Szalacinski/linuxcnc_novaturn_retrofit/README.md

# A LinuxCNC retrofit for the Denford Novaturn
See [here](https://github.com/Szalacinski/mini-rectifier) for the small rectifier boards for the Gecko drivers.
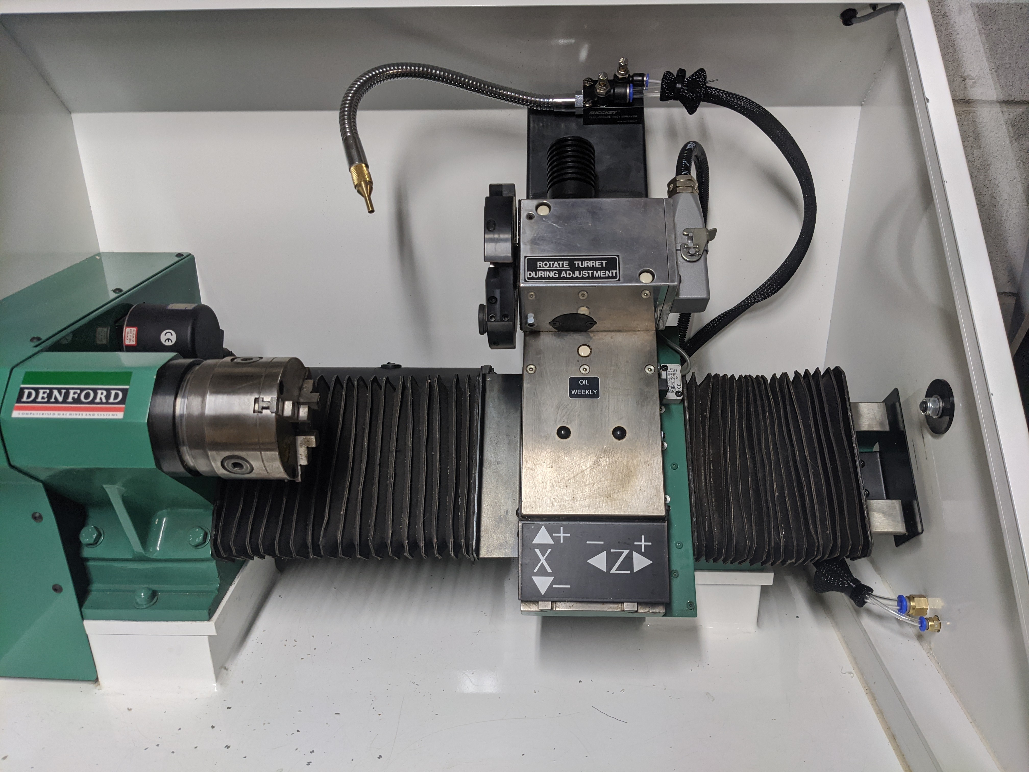
[picture p1: img/01.jpg]
Denford Novaturn CNC lathe
