Szalacinski/linuxcnc_novaturn_retrofit/schematics/mesa_7I85s.sch

## KiCad design schematics/mesa_7I85s.sch (2022-07-25)

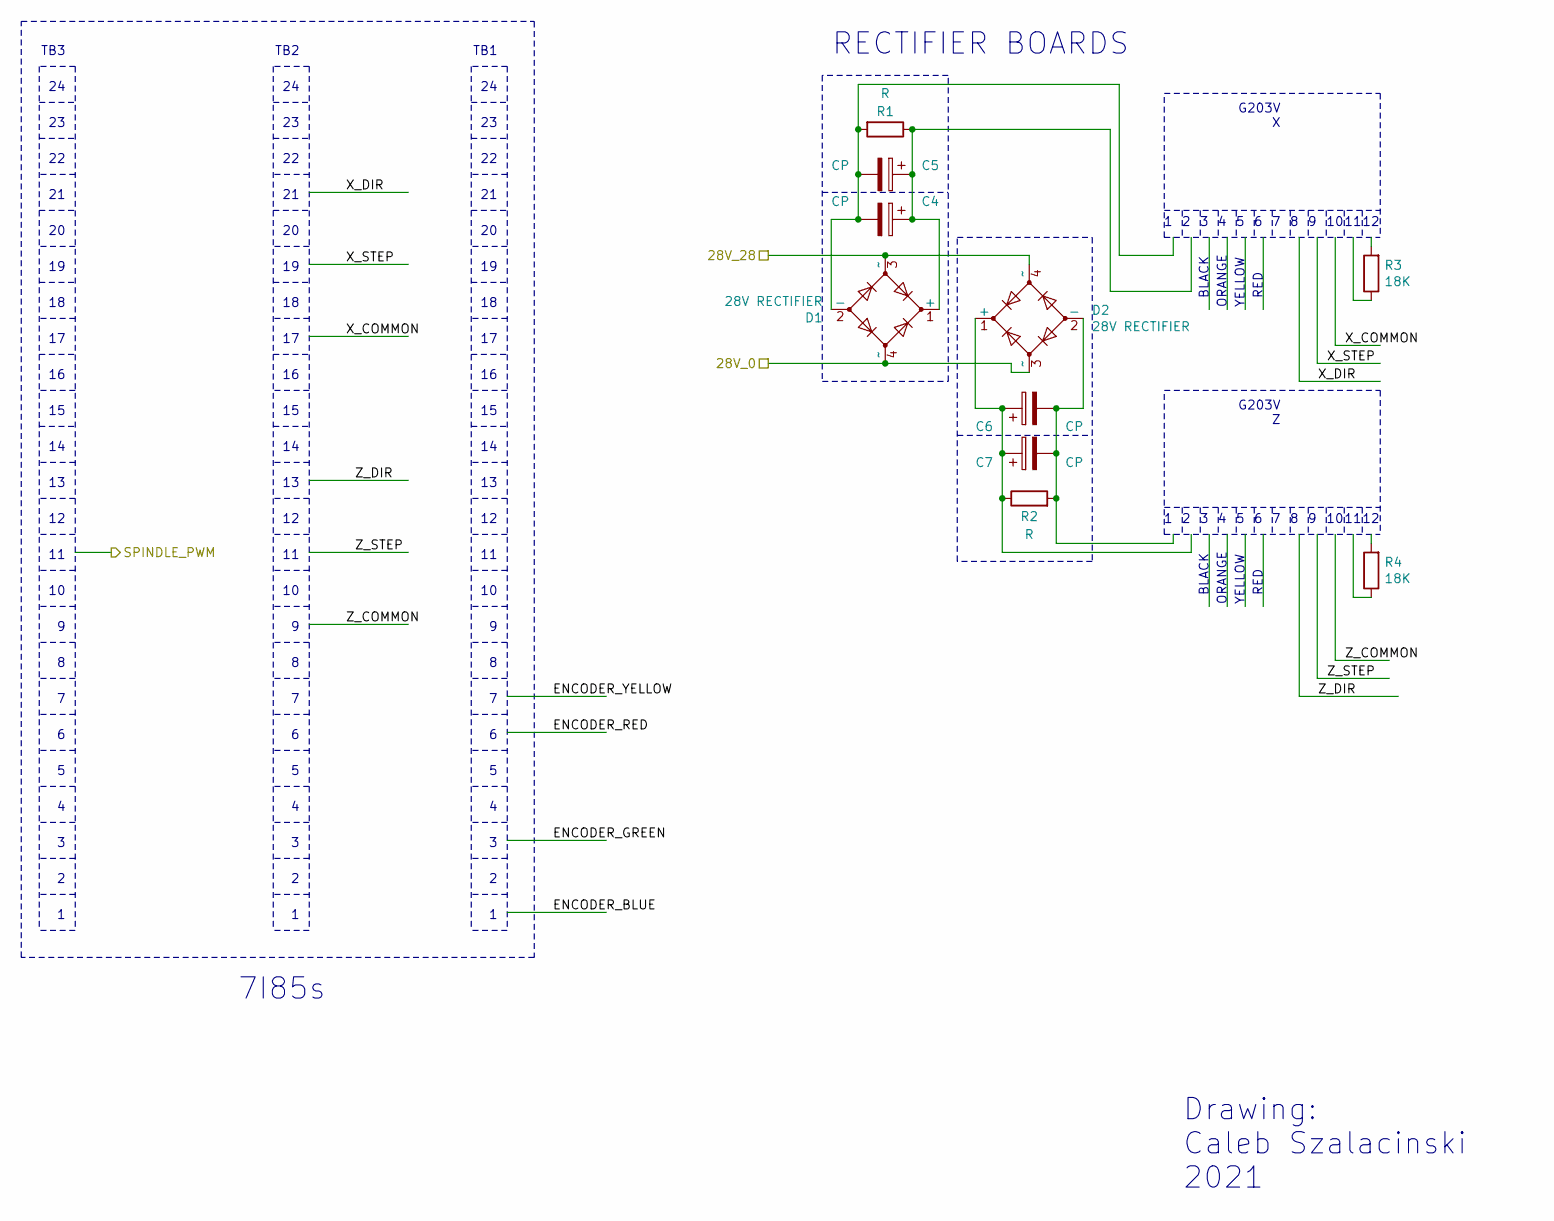
[picture p2: schematic mesa_7I85s.sch]

Parts:
C4, C5, C6, C7: CP
D1, D2: 28V RECTIFIER
R1, R2: R
R3, R4: 18K

Connections:
28V_0: D1.4 (~~), D2.3 (~~)
28V_28: D1.3 (~~), D2.4 (~~)
unnamed: C4.1, C5.1, D1.1 (+), R1.1
unnamed: C4.2, C5.2, D1.2 (-), R1.2
unnamed: C6.1, C7.1, D2.1 (+), R2.1
unnamed: C6.2, C7.2, D2.2 (-), R2.2

Notes on the sheet:
TB1
TB2
TB3
G203V X
G203V Z
RECTIFIER BOARDS
7I85s
BLACK
ORANGE
YELLOW
RED
Drawing: Caleb Szalacinski 2021
