Szalacinski/linuxcnc_novaturn_retrofit/schematics/novaturn.sch

## KiCad design schematics/novaturn.sch (2022-07-25)

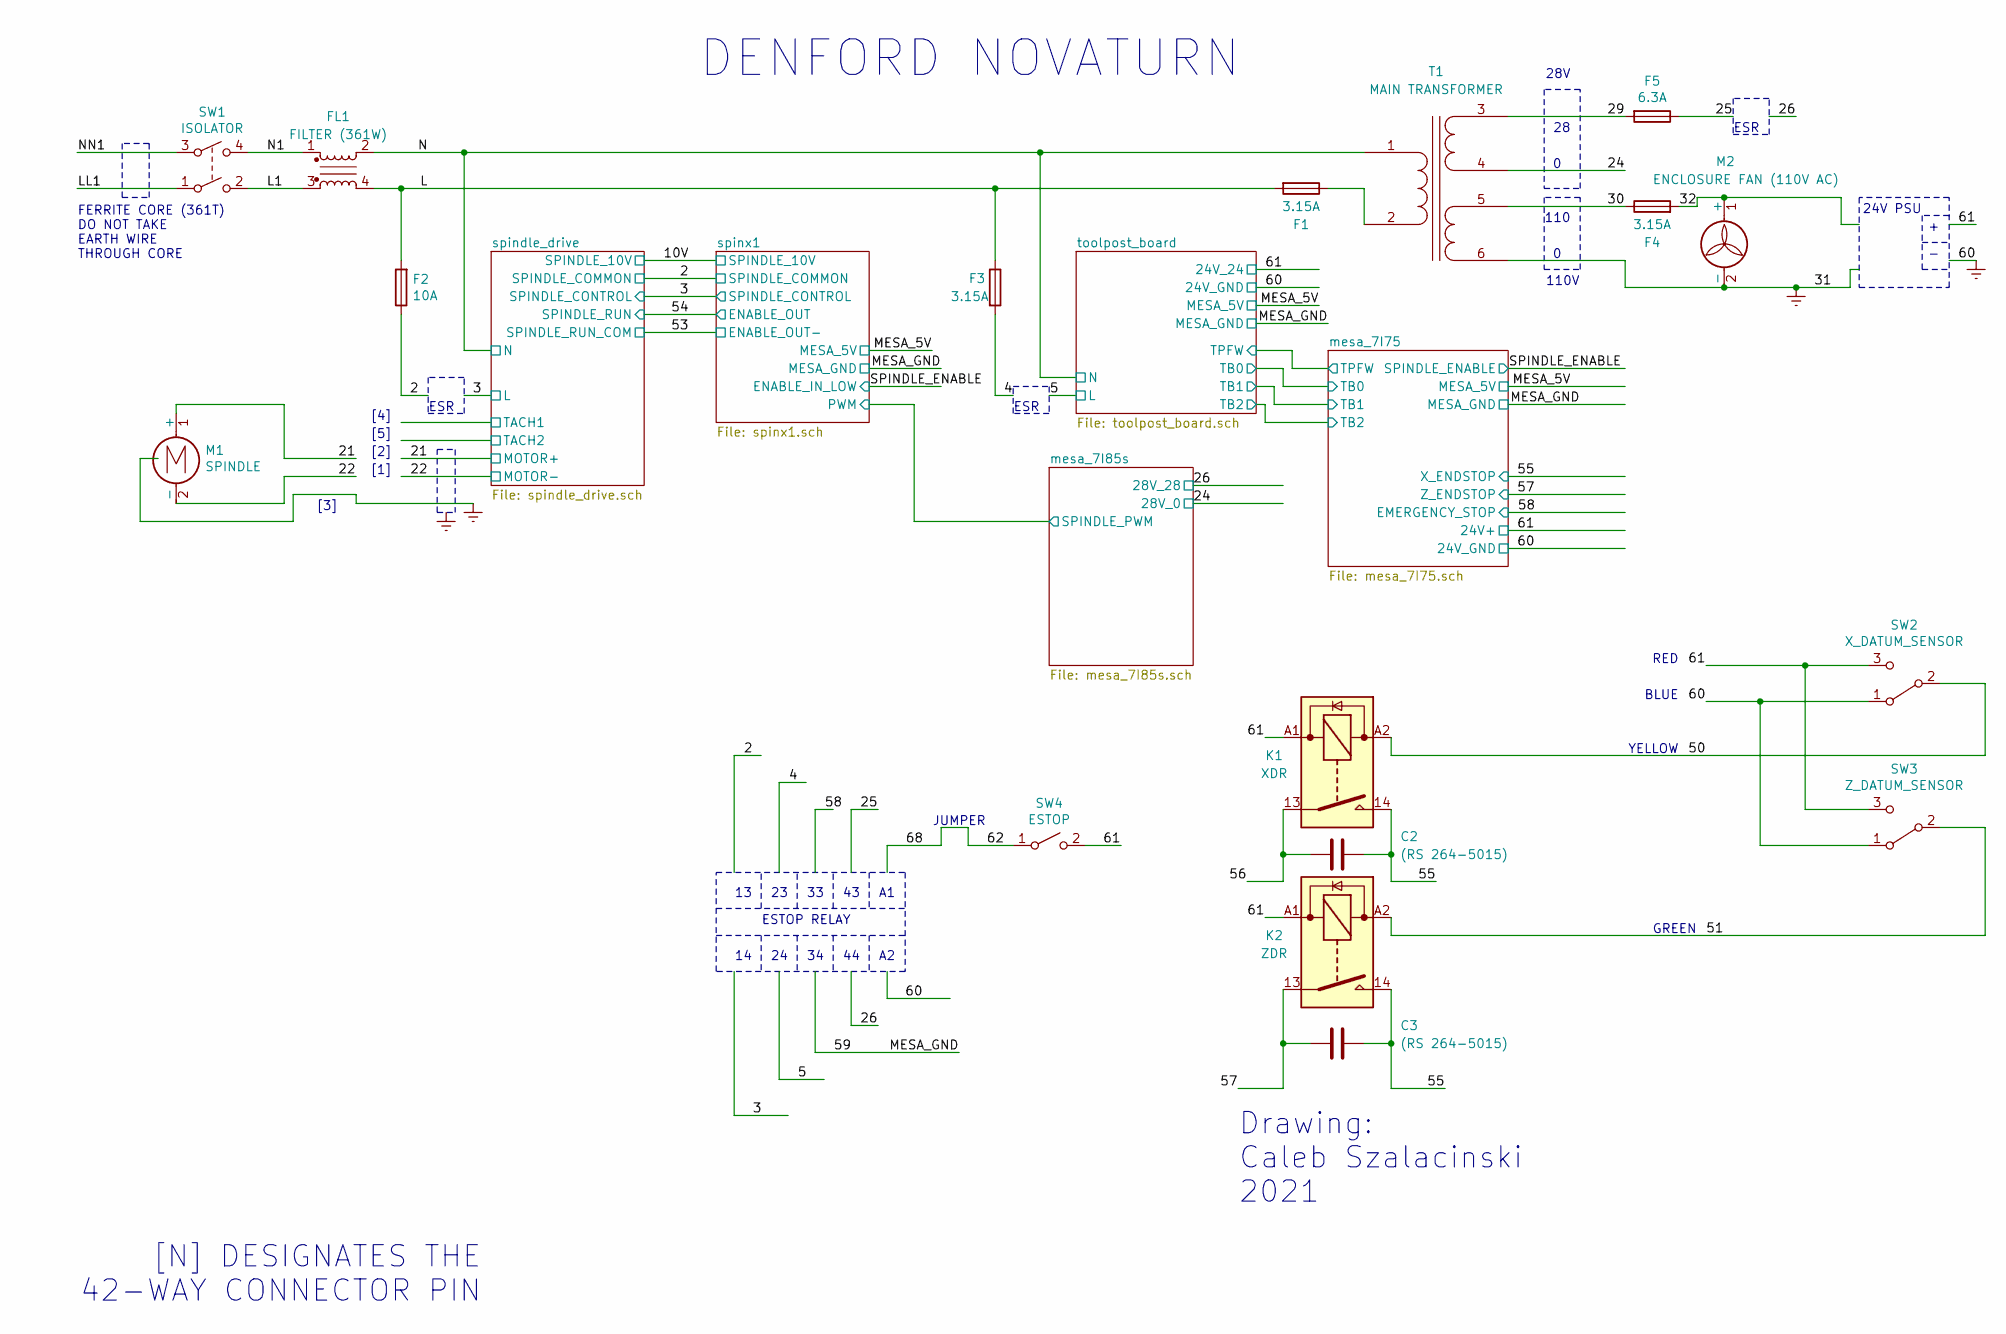
[picture p3: schematic novaturn.sch]

Parts:
C2, C3: (RS 264-5015)
F1, F3, F4: 3.15A
F2: 10A
F5: 6.3A
FL1: FILTER (361W)
K1: XDR; Relay_StandexMeder_DIP_LowProfile
K2: ZDR; Relay_StandexMeder_DIP_LowProfile
M1: SPINDLE
M2: ENCLOSURE FAN (110V AC)
SW1: ISOLATOR
SW2: X_DATUM_SENSOR
SW3: Z_DATUM_SENSOR
SW4: ESTOP
T1: MAIN TRANSFORMER

Connections:
2: F2.1
4: F3.2
21: M1.1 (+)
22: M1.2 (-)
24: T1.4 (SB)
25: F5.1
29: F5.2, T1.3 (SA)
30: F4.1, T1.5 (SC)
32: F4.2, M2.1 (+)
50: K1.A2, SW2.2 (B)
51: K2.A2, SW3.2 (B)
55: C2.1, C3.1, K1.8, K1.14, K2.8, K2.14
56: C2.2, K1.13, K1.14
57: C3.2, K2.13, K2.14
61: K1.13, K1.A1, K2.13, K2.A1, SW2.3 (C), SW3.3 (C), SW4.2 (B)
62: SW4.1 (A)
Earth: M2.2 (-), SW2.1 (A), SW3.1 (A), T1.6 (SD)
L: F1.2, F2.2, F3.1, FL1.4
L1: FL1.3, SW1.2
LL1: SW1.1
N: FL1.2, T1.1 (AA)
N1: FL1.1, SW1.4
NN1: SW1.3
unnamed: F1.1, T1.2 (AB)

Notes on the sheet:
DENFORD NOVATURN
FERRITE CORE (361T) DO NOT TAKE EARTH WIRE THROUGH CORE
[4]
[5]
[2]
[1]
[3]
ESR
[N] DESIGNATES THE 42-WAY CONNECTOR PIN
28V
110V
110
24V PSU
ESR
YELLOW
BLUE
RED
GREEN
Drawing: Caleb Szalacinski 2021
ESTOP RELAY
JUMPER
