Szalacinski/linuxcnc_novaturn_retrofit/schematics/spindle_drive.sch

## KiCad design schematics/spindle_drive.sch (2022-07-25)

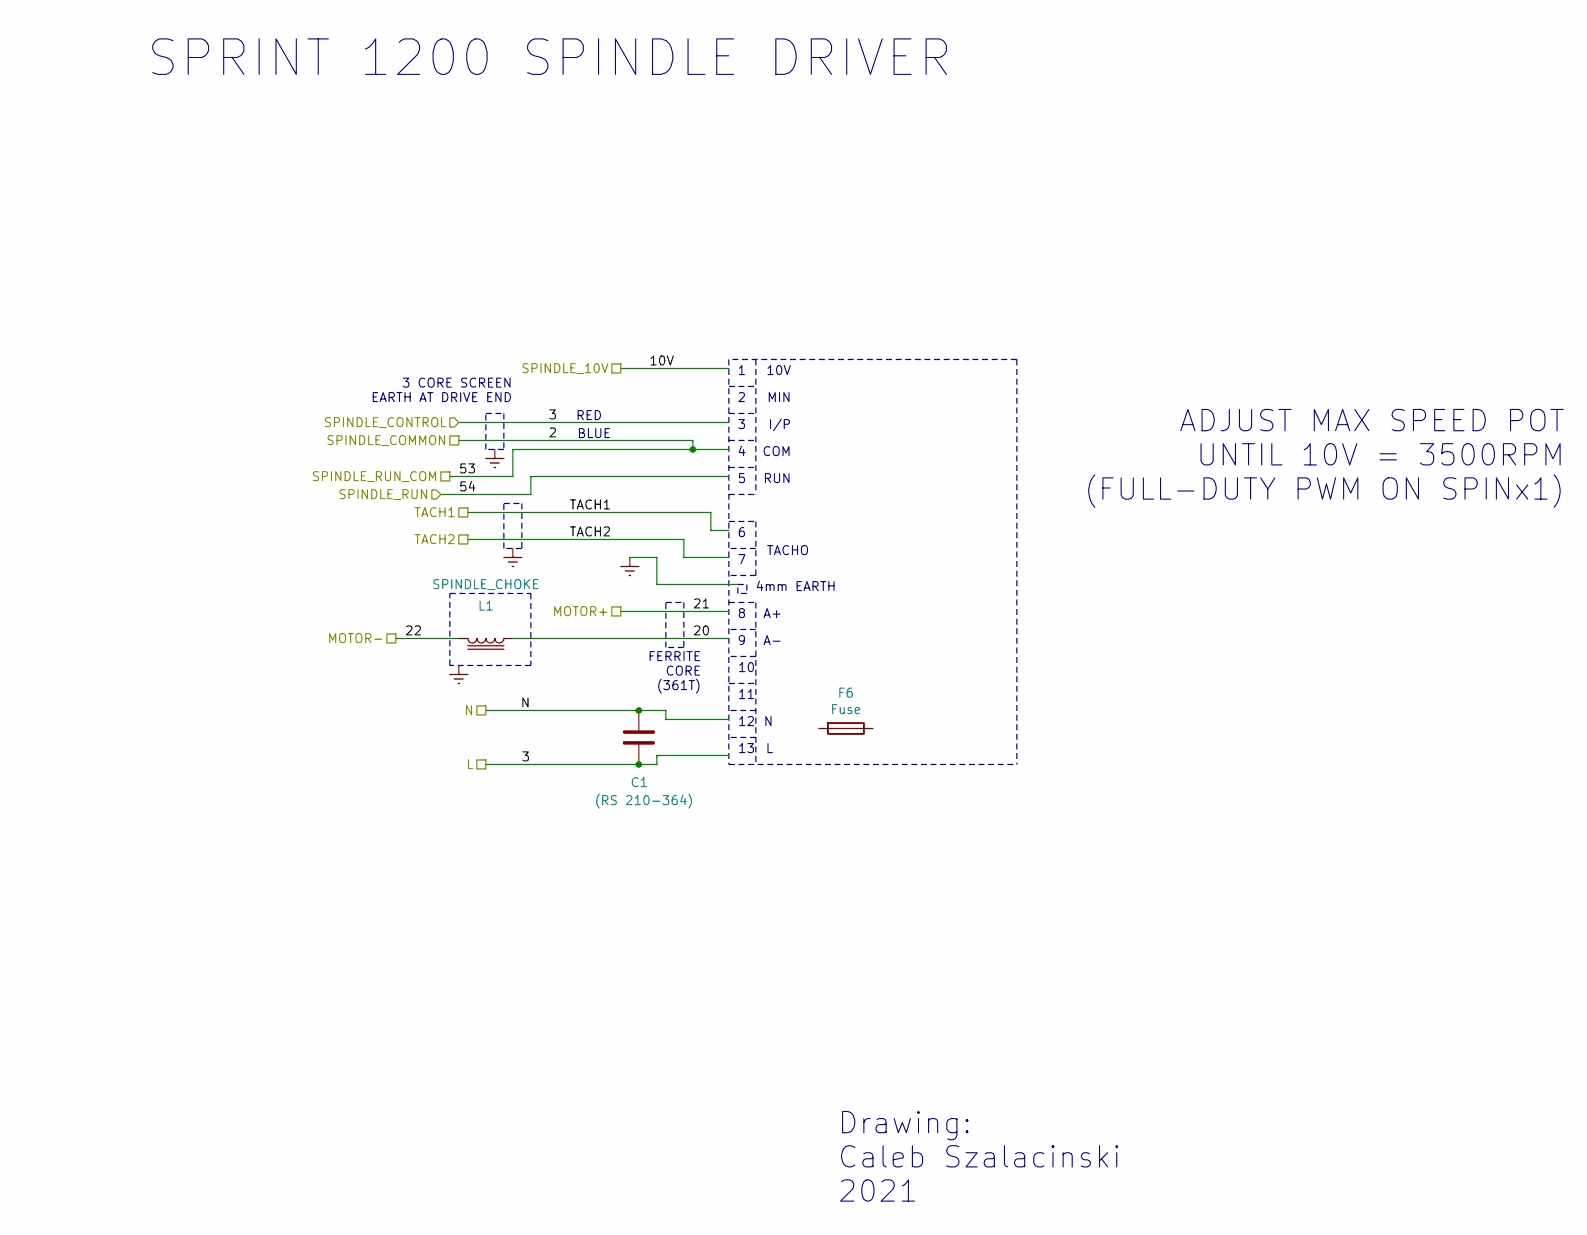
[picture p4: schematic spindle_drive.sch]

Parts:
C1: (RS 210-364)
F6: Fuse
L1: SPINDLE_CHOKE

Connections:
3: C1.2
20: L1.1
22: L1.2
N: C1.1

Notes on the sheet:
10V
MIN
I/P
COM
RUN
TACHO
FERRITE CORE (361T)
3 CORE SCREEN EARTH AT DRIVE END
RED
BLUE
4mm EARTH
SPRINT 1200 SPINDLE DRIVER
ADJUST MAX SPEED POT UNTIL 10V = 3500RPM (FULL-DUTY PWM ON SPINx1)
Drawing: Caleb Szalacinski 2021
