Szalacinski/linuxcnc_novaturn_retrofit/schematics/toolpost_board.sch

## KiCad design schematics/toolpost_board.sch (2022-07-25)

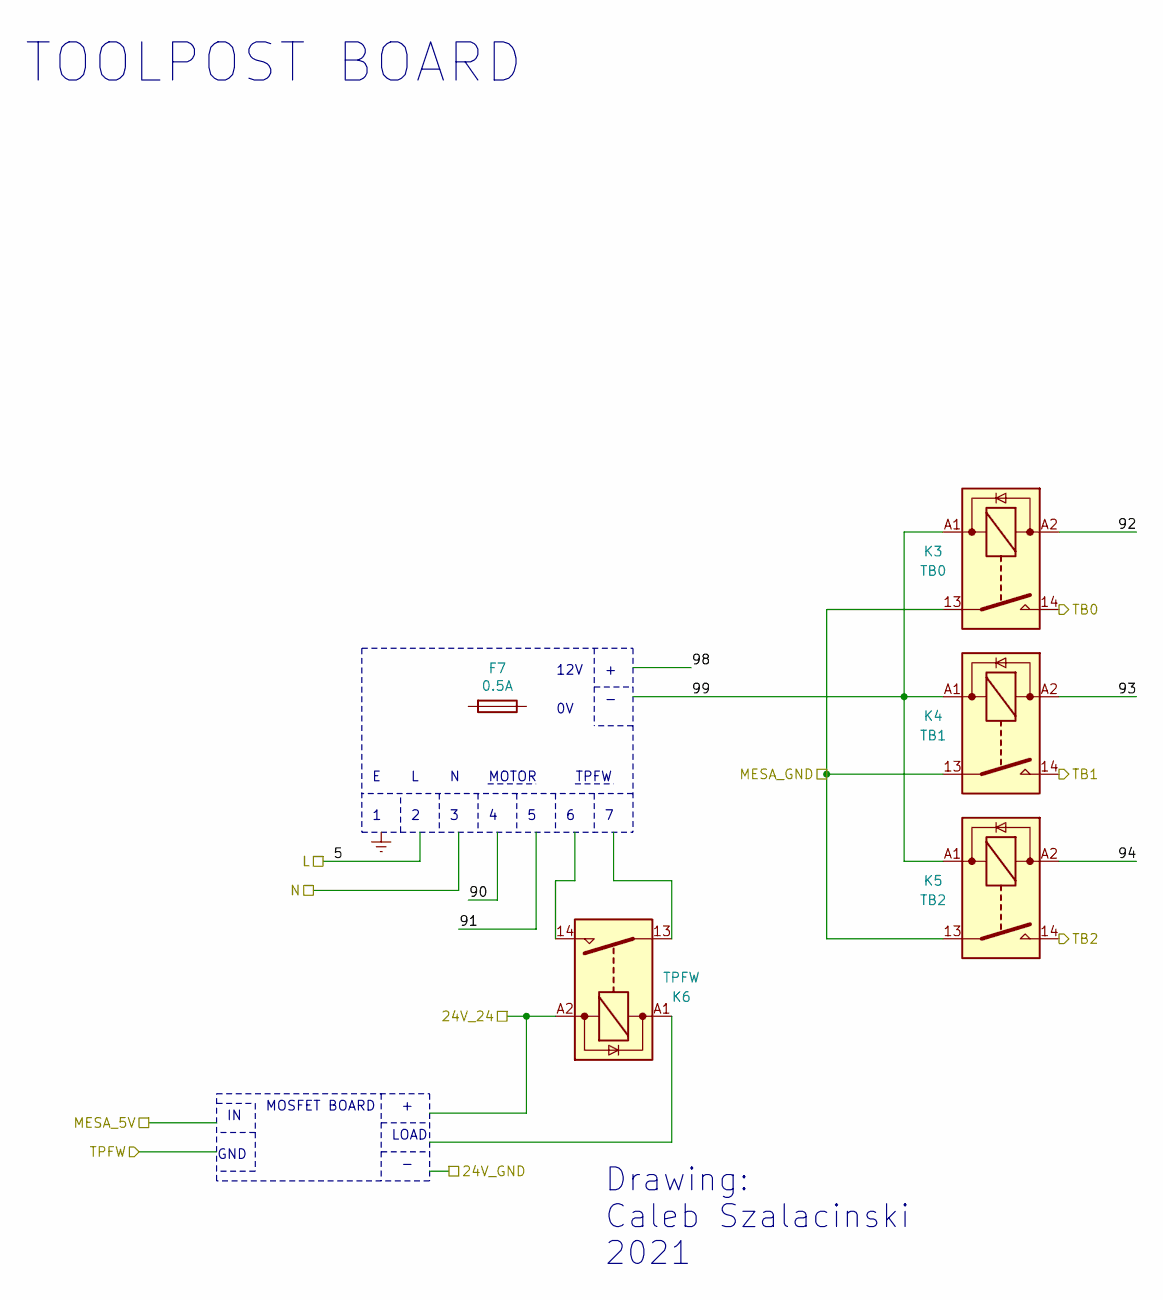
[picture p5: schematic toolpost_board.sch]

Parts:
F7: 0.5A
K3: TB0; Relay_StandexMeder_DIP_LowProfile
K4: TB1; Relay_StandexMeder_DIP_LowProfile
K5: TB2; Relay_StandexMeder_DIP_LowProfile
K6: TPFW; Relay_StandexMeder_DIP_LowProfile

Connections:
24V_24: K6.A2
92: K3.A2
93: K4.A2
94: K5.A2
99: K3.13, K3.A1, K4.13, K4.A1, K5.13, K5.A1
MESA_GND: K3.13, K3.14, K4.13, K4.14, K5.13, K5.14
unnamed: K6.13, K6.14, K6.A1
unnamed: K6.8, K6.14
TB0: K3.8, K3.14
TB1: K4.8, K4.14
TB2: K5.8, K5.14

Notes on the sheet:
12V
MOTOR
TPFW
MOSFET BOARD
GND
LOAD
TOOLPOST BOARD
Drawing: Caleb Szalacinski 2021
